sinara-hw/Zotino/DOC/Zotino_mod.png

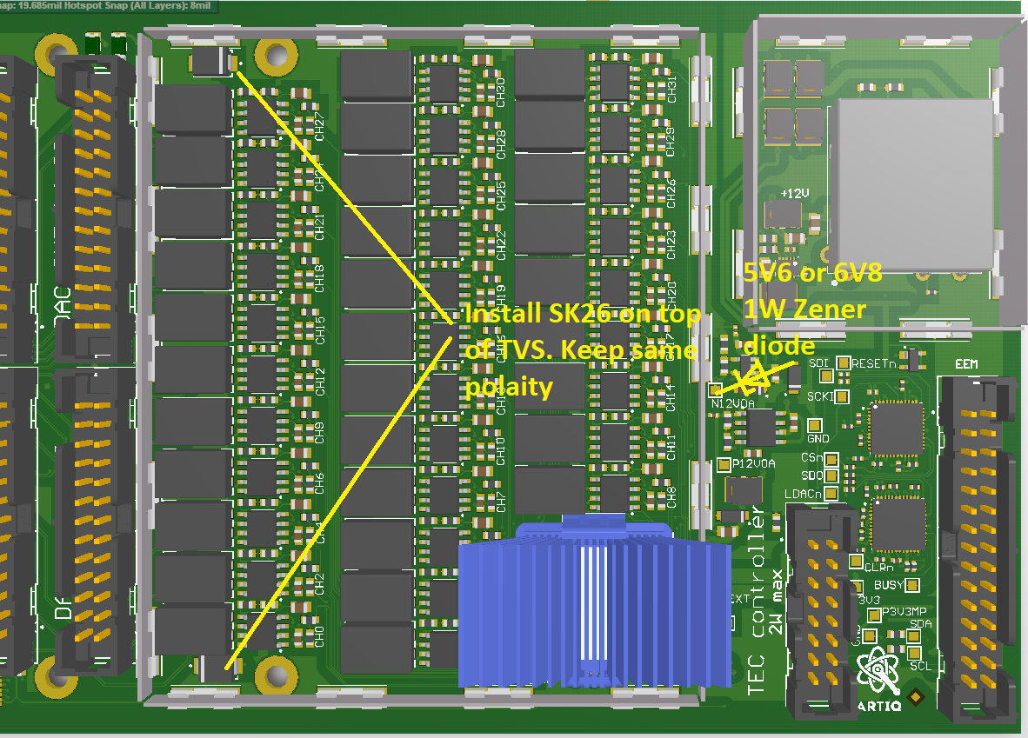
DOC/Zotino_mod.png
