sinara-hw/Zotino/README.md

# Zotino 32-Channel DAC

The Zotino is an ARTIQ-compatible 32-channel DAC. It is in the EEM (Eurocard Extension Module) form factor.

## Design Files

Design files (schematics, PCB layouts, BOMs) can be found at [Zotino/Releases](https://github.com/sinara-hw/Zotino/releases).

This project is mostly edited offline, out of source control, and updated on each release.

## Wiki

More information can be found on the [wiki](https://github.com/sinara-hw/Zotino/wiki).
