sinara-hw/Zotino/SIM/ac response.png

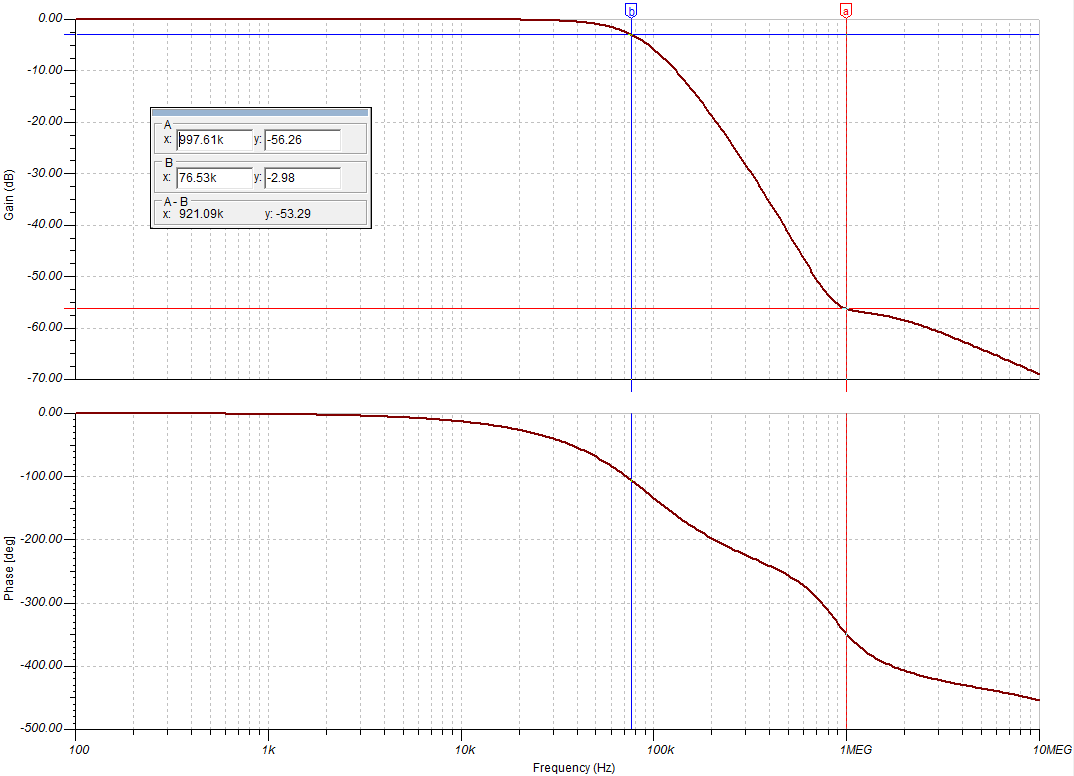
SIM/ac response.png
