sinara-hw/Zotino/SIM/noise spectral density.png

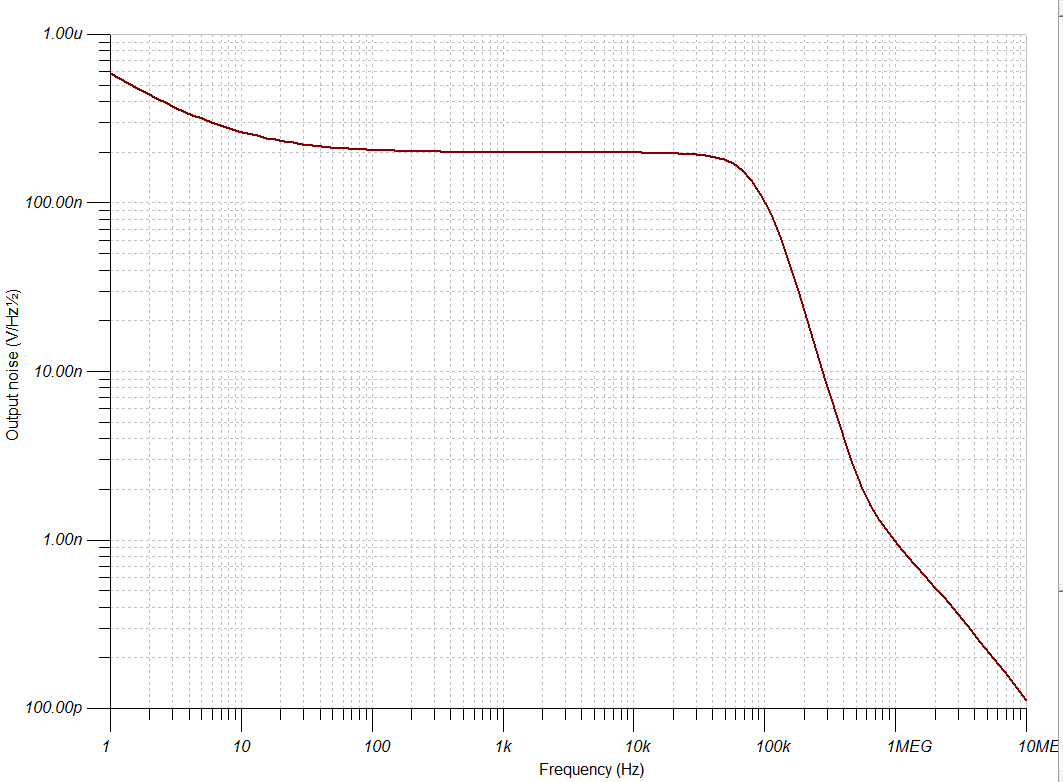
SIM/noise spectral density.png
