sinara-hw/Zotino/SIM/setting time.png

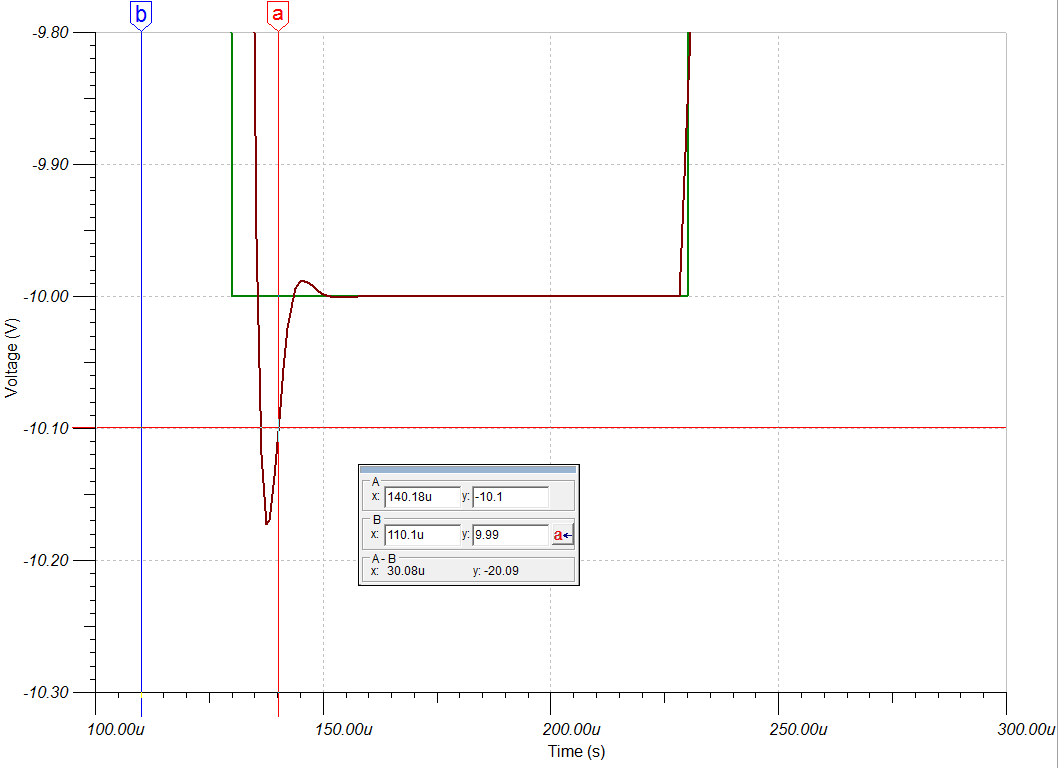
SIM/setting time.png
