sinara-hw/Zotino/(threads)

Thread 1 (2018-04-18):

v1.1 testing

hartytp, 2018-04-18:
- Continued from https://github.com/sinara-hw/sinara/issues/534

- [x] Step response/rise time: switch from -10V to +10V and look at output on scope
- [ ] Noise spectrum with & without constant DAC updates. Look at +-FS and 0V
- [ ] Cross-talk
- [ ] Noise with TEC running
- [ ] Stability with + without TEC connected
- [ ] Small + large signal BW
- [x] DC accuracy as a function of duty cycle (self-heating). Ticked off as this is actually quite tricky to measure and I don't expect it to be a large effect at all. Feel free to untick if you really want to see this measured and are willing to take the data!

hartytp, 2018-04-18:
Note to self, measured temp co looks surprisingly good given the DAC's specifications. However, it was only measured at a single voltage, so it's possible that the results are very different at other voltages. Needs more measurements before we make a final decision about whether to include the TECs as a default population option going forward.

Closed 2019-09-06.

Thread 2 (2018-05-21):

DAC death

sbourdeauducq, 2018-05-21:
Every ~15s my Zotino stops producing an output signal for a few seconds, and the blank period is followed by a burst of noise:
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
This is with a kernel that produces a 1kHz tone:
```python
import struct

from artiq.experiment import *
from artiq.coredevice.ad53xx import *

class Tone(EnvExperiment):
    def build(self):
        self.setattr_device("core")
        self.setattr_device("zotino0")

    @kernel
    def run(self):
        self.core.reset()
        self.zotino0.init()
        delay(1*ms)
        while True:
            self.zotino0.write_dac(1, 0.1)
            self.zotino0.load()
            delay(0.5*ms)
            self.zotino0.write_dac(1, -0.1)
            self.zotino0.load()
            delay(0.5*ms)
```

Even with nothing running on the core device, the bursts of noise are still observed, which points to a  hardware problem:
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

sbourdeauducq, 2018-05-21:
This behavior is observed on at least 2 channels. I don't have another board to test.

gkasprow, 2018-05-21:
Before I manage to recreate the issue, could you please have a look at the supply rails?
+/-12V which supplies DAC and buffers.

sbourdeauducq, 2018-05-21:
Where do I measure those? The PDF schematics aren't in https://github.com/sinara-hw/Zotino

sbourdeauducq, 2018-05-21:
Yep, the power supply is crapping out, here is the -12V:
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

gkasprow, 2018-05-21:
schematics are in [releases ](https://github.com/sinara-hw/Zotino/releases)
OK, so it seems to be the power supply issue. Please check if the power is problematic before the regulators.
What is the output load ?

sbourdeauducq, 2018-05-21:
> What is the output load ?

Open, I only have the scope (1M) connected.

gkasprow, 2018-05-21:
please measure V+ and V- with the scope
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

gkasprow, 2018-05-21:
please also check if the DAC od the LDO above N12V0A is getting hot.

sbourdeauducq, 2018-05-23:
The +12V is working correctly.
The -12V at the output of the LDO has the problem shown above, but its input is stable. It does get very hot. So I guess we are seeing the LDO thermal shutdown.

sbourdeauducq, 2018-05-23:
There is +/-15V at the inputs of the LDOs. Isn't that a bit high?
Also, the -12V glitches only begins to occur after the board has been running for a few minutes, which is consistent with thermal shutdown.

sbourdeauducq, 2018-05-23:
From a cursory inspection (no thermal camera here yet), nothing else on the board other than the DAC chip gets hot. I wonder if it may be drawing more than its specified current.

sbourdeauducq, 2018-05-23:
Contrary to what I thought, the DAC chip on my Zotino 1.1 is not burned, so I have added a heatsink to it and I am testing that board now. The switching regulator output is still +/-15V.

sbourdeauducq, 2018-05-23:
That 1.1 board doesn't have the problem. The -12V LDO is colder, too.

gkasprow, 2018-05-23:
we recreated same problem in the lab. the Zotino board was placed on the most right side of the crate where cooling is not sufficient.

sbourdeauducq, 2018-05-23:
The problem is systematically happening on the v1.2 board, when it is is exposed to air at ambient temperature without hot objects nearby. What should I do, turn on the TEC cooler?

sbourdeauducq, 2018-05-23:
Even with the board outside the crate, the bug is present.

gkasprow, 2018-05-23:
you can try to remove the Peltier module and attach the heatsink directly.

hartytp, 2018-05-23:
@gkasprow you think this is thermal runaway in the dac? That doesn't seem likely to me. On our boards, with no forced air, the dac is barely warm to touch. How hot is it on your board before this issue occurs?

gkasprow, 2018-05-23:
This happens when the DAC even for short moment gets its temperature exceeded. It gets damaged, it still works but consumes much more current so it enters this thermal trip quickly.
Let's add thermal protection in next revision of Zotino which will switch off the power when temperature is i.e. 55 degrees and indicate it with LED.

hartytp, 2018-05-23:
@gkasprow did you test that by heating the dac with a hot air gun?

I just don't get this:
- iirc the dac is rated to normal operation at 85C die temp, and max tem 120C
- the datasheet has curves for current draw versus temperature which show no runaway
- the power consumption is low so the die should only be a few C hotter than the case (based on specifies thermal impedance)
- so unless the dac case / pcb is quite a bit hotter than 85C there should be no problem at all. On my board it just wasnt that hot. So why are we seeing this?
- I've used these DACs on eval boards in enclosures stabilised by resistive heating with no problems. Based on your explanation this should not be possible

So I think there must be some other cause for all of this. What do you think?

sbourdeauducq, 2018-05-23:
> Let's add thermal protection in next revision of Zotino which will switch off the power when temperature is i.e. 55 degrees and indicate it with LED.

If that's really the problem, this won't be a solution: the thermal protection will just be activated all of the time in the field. Again, the bug is present on my board *outside* the chassis, and it's not the hot HK weather, I had AC in the lab.

hartytp, 2018-05-23:
Note to self, let's also check that this isn't something dumb like we've used some DAC variant that's only specified over a very narrow temperature range.

gkasprow, 2018-05-23:
I also have AC in my lab and the failure happened today.
The SMPS delivers max +/- 15V so even if the LDO gets unstable, it is still within safe operation area.
I have the DAC devkit so will give it a try.

gkasprow, 2018-05-23:
I attached the heat sink directly to the DAC after removing the Peltier, the current consumption is stable and the DAC is cold. The board is on the bench and I have the air flow generated by 12V fan supplied from 10V.

gkasprow, 2018-05-23:
I removed the fan and the current consumption started growing. When it had grown by 20mA, I turned the fans on and it felt back to the original value.

jordens, 2018-05-23:
It might generally be wise to enable thermal shutdown in the AD5372 by default in ARTIQ.

hartytp, 2018-05-23:
> I removed the fan and the current consumption started growing. When it had grown by 20mA, I turned the fans on and it felt back to the original value.

Do you know from which rail the current was drawn?

hartytp, 2018-05-23:
Were your observations consistent with the data sheet?

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

hartytp, 2018-05-23:
> It might generally be wise to enable thermal shutdown in the AD5372 by default in ARTIQ.

We did consider that in the past (and it might not be a bad idea to do implement it), but the thermal shut-down only kicks in at 130C die temperature. IIRC, @gkasprow felt that by that point the DAC had been destroyed. Also, it's not great protection, as it doesn't help if the user powers the board on for a while before programming. Better to ensure that Zotino doesn't spontaneously die under normal use.

gkasprow, 2018-05-23:
I took the ADI devkit, powered it on and heated to 97 degrees. Did not observe any change in current consumption. -12V and +12V was below 10mA (bench PSU current display resolution)

hartytp, 2018-05-23:
Good!

So, either the DAC on Zotino has been damaged by something, which is leading to this behaviour. Or, we have some connection on Zotino that's different to the eval board. The question is which one? Maybe try disconnecting all the OpAmps from the DAC outputs?

gkasprow, 2018-05-23:
My DAC on Zotino is already broken. What I can do is to measure the output current on the RC filter resistors.
I will also check how the +/- 12V rails wake up.

jordens, 2018-05-23:
I am pretty sure that the thermal shutdown is designed to prevent and identify (since it doesn't clear itself) destructive temperature excursions. And I'd bet that if the damage is thermal, the shutdown would trip. But yes, I'd also bet that the problem is not bad cooling.

gkasprow, 2018-05-23:
the +/- 12V rails wake up in monotonic way. +12 wakes up faster than -12V.

hartytp, 2018-05-23:
> I am pretty sure that the thermal shutdown is designed to prevent and identify (since it doesn't clear itself) destructive temperature excursions. And I'd bet that if the damage is thermal, the shutdown would trip. But yes, I'd also bet that the problem is not bad cooling.

Exactly.

gkasprow, 2018-05-23:
I let the DAC to trip. Then I switched on the fan and the current consumption got lowered to initial value...
So it does not seem to be any latchup effect.

gkasprow, 2018-05-23:
There is one difference between eval kit and Zotino.
On Eval kit the pin 13 is grounded.
In datasheet is is marked as NC

gkasprow, 2018-05-23:
I connected it to GND but it did not help

gkasprow, 2018-05-23:
the DAC accepts up to 5V on digital supply. We have 3.3V supply which also supplies the LVDS drivers. And these drivers would be killed first.

gkasprow, 2018-05-23:
I'm just curious if this un-connected NC pin could kill the DAC. The reference can survive up to 40V on its input.
The DAC draws excessive current from its negative rail.

hartytp, 2018-05-23:
Sure, my point is just that characterizing the dead DAC carefully may not tell you anything about what killed it.

gkasprow, 2018-05-23:
I have one more Zotino that works correctly. I shorted pin 13 to GND and that's the only think I can do.
I can heat it to 90 degrees and see how it behaves.

gkasprow, 2018-05-23:
I have one more Zotino that works correctly. I shorted pin 13 to GND and that's the only think I can do.
I can heat it to 90 degrees and see how it behaves.

gkasprow, 2018-05-23:
I posted it here
https://ez.analog.com/message/350275-failing-ad5372-dacs

dhslichter, 2018-05-23:
Looks like AD suggests powering up as -12V, +12V, +3.3V:

https://ez.analog.com/thread/47483

gkasprow, 2018-05-23:
I've noticed that. It is recommended pattern. We should fix it in next revision just in case.
I applied other sequences to the devkit and nothing happened.

hartytp, 2018-05-23:
@dhslichter I've seen that post before, but I don't think it applies to us. Importantly, Zotino should meet all the absolute maximum ratings by design. e.g. the digital sequencing shouldn't matter, since the inputs/outputs connect to ICs that run from the same regulator as Zotino.

Also, I've run eval boards for this DAC from bench top PSUs with no real care paid to power sequencing and never seen an issue like this.

hartytp, 2018-05-23:
> The reference can survive up to 40V on its input.

The data sheet says 5.5V max for VREF0 and VREF1

hartytp, 2018-05-23:
hmm I really can't think of anything to do here apart from removing all components from a working board until we strip it down to the very most basic design. If that works, then add things one by one and try to see which causes DAC death.

gkasprow, 2018-05-23:
Another observation - the board with issues, has them from very beginning. There are boards that work perfectly fine.
I tried with temperature and various supply sequences on devkit and they didn't harm it.
I will try the same with the board that works fine. But it's quite possible that we never find the problem in this way.
I'll do yet another thing - buy a few DACs and will work on the same board that causes issues.
I will replace the DAC on particular board and will see if the issue reappears.
If not, I will play with voltage sequencing and logic levels during power up...

gkasprow, 2018-05-23:
@hartytp I mean 40V for reference IC.

dhslichter, 2018-05-23:
> Also, I've run eval boards for this DAC from bench top PSUs with no real care paid to power sequencing and never seen an issue like this.

Same here, I merely mentioned it in case it might make a difference.

sbourdeauducq, 2018-05-25:
Cooling the DAC chip works around the problem.

klickverbot, 2018-05-31:
For the record, one of our boards (v1.2) has developed this issue now as well (N12V0A dropping to ~2.5V every few seconds).

gkasprow, 2018-05-31:
I've ordered a bunch of DAC chips and will play with them to identify a moment where the DAC starts consuming excessive power on negative rail. Did not manage to do it with devkit.

cjbe, 2018-06-01:
To add to @klickverbot's comment, the v1.2 board we saw this problem on was new, and showed the problem within a few hours of powering it on for the first time (i.e. we powered it on, and saw the problem as soon as we looked for it).

There has been a v1.1 Zotino sitting in the same airflow within 10cm of the problematic v1.2 - this v1.1 Zotino has been working for a month with no issues.

jordens, 2018-06-01:
I enabled OT shutdown by default. This should at least keep the chips from dying in many cases. https://github.com/m-labs/artiq/commit/2c344686d9b0f8c3f8cc65db692468e7ac443310

sbourdeauducq, 2018-06-02:
Here is a picture of the DAC on the faulty board, in case this is an issue with a certain batch of chips.
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

hartytp, 2018-06-14:
@gkasprow any luck tracking this down. I'm going to buy a few of the DAC chips and have a look at the dead board here.

hartytp, 2018-06-14:
@gkasprow did you see that you got a follow up question from ADI? https://ez.analog.com/message/350275-failing-ad5372-dacs

hartytp, 2018-06-14:
@gkasprow Having said that, I don't see the BCPZ package stocked in any of the usual places on less than a 6 week lead time! Am I missing something?

jordens, 2018-06-14:
That might be a production issue. Digikey says that delivery is past due.

hartytp, 2018-06-14:
Yes, and the power detectors for booster are on 1 month lead time as well...

gkasprow, 2018-06-14:
Lead time is serious problem that touches the industry. The economy in
China boosted so much that they consume all resources. Look at the prices
of 100nF capacitors - they increased over 300% last year. It's extremely
hard to get i.e. 10uF X7R 0805 capacitors.

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

hartytp, 2018-06-14:
Ouch!

Out of curiosity, did you order any more DACs to help debug this issue? If not, does that mean that we can't do any work to try to fix Zotino for another 6 weeks?

gkasprow, 2018-06-14:
I did, tomorrow I will take them from Technosystem. Ordering things at the
WUT is real nightmare.

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

hartytp, 2018-06-15:
:+1:

dhslichter, 2018-06-15:
Or buy from Verical [here](https://www.verical.com/pd/analog-devices-data-acquisition---dac-AD5372BCPZ-1029554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), or directly from Analog Devices [here](http://www.analog.com/en/products/digital-to-analog-converters/standard-dac/precision-dac/bipolar-da-converters/ad5372.html).  For reference, [Octopart](https://www.octopart.com/) is a pretty awesome tool for figuring out who has what in stock....

gkasprow, 2018-06-15:
It's not a problem with buying things but letting WUT bureaucracy to pay for them. It takes months. Doing via private company is simpler :)

hartytp, 2018-06-18:
> directly from Analog Devices here

Only if you want to buy a tray of 260 DACs.

> Or buy from Verical here,

even there, it's a MOQ of 8 and two weeks before shipping. Plus the fees/paperwork involved with shipping from the US.

I was just surprised that none of the usual suspects stock this atm, but I suspect it's because we're using the obsolete package.

hartytp, 2018-07-03:
Switched the DAC for a new one, but the N12V0 is still at 0.7V.

Maybe the negative regulator is struggling to startup with the heavy load presented by all the OpAmp biases. I'll add an RC delay on the P12V0 and see if that helps...

hartytp, 2018-07-03:
@gkasprow Two observations, which might help to explain all this:
1. The negative regulator is 200mA, while the positive regulator is 500mA. So, it should be expected that the positive rail will always switch on faster than the negative rail
2. The negative regulator goes high-Z when its output is reverse biased.

Given the relatively high forwards voltage of the Zener diodes installed on Zotino by default, it should thus be expected that the negative regulators will often go into lock up

gkasprow, 2018-07-03:
did you add the schottky diode?

hartytp, 2018-07-03:
Yes, but the one I added seems to have died...

gkasprow, 2018-07-03:
I'm testing the board I have and power sequencing looks OK
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

klickverbot, 2018-07-03:
Hmm… The 1PS79SB30 can supposedly take 300 mA peak forward current – if it died from that, where is this much current even being sourced from safely?

gkasprow, 2018-07-03:
another scale
![Uploading tek00129.png…]()

gkasprow, 2018-07-03:
It could happen that Zotino starts with some load connected. Then the current drawn from negative source could be much higher causing the LDO startup to fail and triggering the latchup in DAC.

hartytp, 2018-07-03:
> are U sure there is -13V present ?

Yes, the +-13V rails start up nicely.

> It could happen that Zotino starts with some load connected. Then the current drawn from negative source could be much higher causing the LDO startup to fail and triggering the latchup in DAC.

Yes, but right now I'm not even seeing a hundred mV negative at startup, which is surprising...

gkasprow, 2018-07-03:
Maybe the negative DAC supply is shorted with some output?

hartytp, 2018-07-03:
> Maybe the negative DAC supply is shorted with some output?

What would that explain? My observation is that when the N13V0 supply comes on, the N12V0 does not produce any voltage (even -20mV or so). After 20ms or so, the P12V0 regulator switches on and the N12V0 rail goes to +0.7V (the Zener diode forward conductance). That suggests that the N12V0 regulator is dead. But, it should be very hard to kill this regulator, so I have no idea what happened...

gkasprow, 2018-07-03:
this would explain too high current drown by negative DAC rail. Is the LDO getting hot?

hartytp, 2018-07-03:
After disconnecting the positive LDO shutdown pin, the negative rail now comes on to -0.5V. +12V supply current draw is 100mA.

hartytp, 2018-07-03:
What's odd is that the LDO output starts up very slowly (maybe 10s to reach -0.5V). But, the +12V supply current goes immediately to 100mA (even when the LDO output voltage is very low). The -12V rail discharges equally slowly, suggesting that it's not just shorted.

hartytp, 2018-07-03:
> Is the LDO getting hot?

Not noticeably

gkasprow, 2018-07-03:
When I was playing with Sayma, i noticed that negative LDO can disable itself when started with positive voltage. But Schottky diode managed to prevent such case.
You can send it to me for further examination.

marmeladapk, 2018-07-03:
@gkasprow We have one Zotino which overheats, mounted leftmost in our 3U crate.

gkasprow, 2018-07-03:
I'm just using it.

hartytp, 2018-07-03:
@gkasprow The 100mA current draw I see on the 12V rail when the positive LDO is shutdown is consistent with the expected current draw from the LVDS interface. So, it seems that on this board the negative LDO is just dead.

Let me post this Zotino back to you for further examination. The symptoms it displays (no -12V supply) are different to all the other Zotinos we've looked at so far, which all have high current draw on the negative rail, so it's probably a different issue entirely.

hartytp, 2018-07-03:
@gkasprow let's confirm once and for all that we understand what's going on here. How about this:
- take a working Zotino, which does not display this issue. Maybe try taking the damaged one and replace the DAC and check that it behaves normally, according to the data sheet
- replace the Zener diodes with Schottky diodes such as SS14
- use a VHDCI carrier card to connect Zotino to a remote programmable 12V supply
- connect the -12V supply to a digitally readable voltmeter
- do not fan cool it, so that any issues with the DAC are easy to spot (fan cooling should not be necessary to avoid damage)
- now run the following measurement 1000 times or so:
  - power Zotino on
  - wait a second or so for everything to start up
  - measure the negative supply rail a few times over 1 second to look for issues
  - power the board down
  - wait a few seconds
- if that works then replace the Schottky diodes with the Zener diodes and repeat the measurement

Hopefully, we will see that nothing breaks with the Schottky diodes, but it dies quickly with the Zener diodes. In that case, we know that we can resolve it by swapping the diodes on all boards as well as any dead DACs.

How does that sound? Can you do that measurement at some point in the next few days, please?

gkasprow, 2018-07-03:
@hartytp Yes, I will.

hartytp, 2018-07-03:
Amazing, thanks Greg.

gkasprow, 2018-07-04:
I got 3 Zotinos, but they were already tested. I hope the DAC survived. I will have tomorrow a few spare DAC chips. I can do tests next week.

gkasprow, 2018-07-05:
@hartytp I got your ZOtino.
The DAC chip seem to be alive, it consumes current close to zero.
But I've noticed that the AFE part consumes quite high current when the voltage is rising.
When positive voltage is lower than 2.1V, the negative consumes nearly 100mA. When it is higher, it drops to 40mA (AFE current).
The negative current drops suddenly once negative voltage exceeds 3.0V
So this would explain very fragile nature of power sequencing. Any imbalance causes that either negative wakes up later or not at all.

hartytp, 2018-07-05:
@gkasprow good catch! That explains a lot.

So, the best solution is probably to add power sequencing for the next version to turn the negative rail on first.

To fix this version, shall we add an RC delay to the positive regulator enable as well as the Schottky diodes?

gkasprow, 2018-07-05:
With SK26 diode, the negative voltage goes to -0.33V for a while.

gkasprow, 2018-07-05:
I wouldn't leave it as it is.

gkasprow, 2018-07-05:
I compared 4 diodes at 150mA:
S5189 : 0.31
SK26 : 0.31
SS18: 0.47
SS34: 0.33V

hartytp, 2018-07-05:
> I wouldn't leave it as it is.

I'm not sure I follow you here. Do you mean "I wouldn't change anything; leave it as it is." Or do you mean "I wouldn't leave it as it is; we must change something."?

gkasprow, 2018-07-05:
I meant that I'm not sure if we can leave these +0.33V on negative rail.

hartytp, 2018-07-05:
Yes, I think we should add some proper power sequencing to turn the negative rail on first and off last.

For the time being, an RC delay on the positive regulator should fix it, right?

gkasprow, 2018-07-05:
Let me check it first :)

gkasprow, 2018-07-05:
the negative LDO is simply dead. it does not consume any current

gkasprow, 2018-07-05:
I installed new one and it is still dead :D

hartytp, 2018-07-05:
Bad solder joint somewhere?

gkasprow, 2018-07-05:
nope, I soldered LT1964ES5-SD#TRPBF instead which has shutdown pin instead of BYP pin ...

gkasprow, 2018-07-05:
And I cannot find which one was installed originally in your board

hartytp, 2018-07-05:
@gkasprow I'm pretty sure I checked the package markings and the one that was originally on my board was the BYP model.

gkasprow, 2018-07-05:
I'm surprised that in rev1.0 there was used LTVX version (with shutdown) instead.. And I simply moved the chip to v1.2 :)

gkasprow, 2018-07-05:
after I replaced the LDO and added SK26 diode, your board seem to work.

hartytp, 2018-07-05:
> after I replaced the LDO and added SK26 diode, your board seem to work.

Glad to hear it!

If you hold the positive regulator in shutdown then what is the supply current? Do you think it would make sense to add power sequencing that holds the positive rail in reset until the negative rail has come on?

gkasprow, 2018-07-05:
@hartytp there are two things that need to be fixed in next revision:
- usage of higher current  negative LDO. It's quite possible that on some boards 200mA of LDO may be not sufficient to deliver inrush current for AFE
- Schottky diodes. SS14 is not sufficient, it needs to be SK24 or another with low voltage.
- Optionally power sequencing for positive voltage to make sure it wakes up slightly later. But with protection diodes and stronger LDO I'm not sure if this is really necessary.

hartytp, 2018-07-06:
@gkasprow hmm...combining a shcottly diode in shunt to ground at both LDO outputs, with a 3V Zener between the negative regulator input and output might be the best approach here. It's also easy to patch existing boards.

hartytp, 2018-07-06:
Anyway, @gkasprow please can you pick which solution you think is best (higher current negative LDO v Zener diode) and suggest which components we should use. We should then order the components and verify that the boards work.

I'd really like to close this issue soon so that we can finish Zotino!

gkasprow, 2018-07-06:
We can simply use 2 LDOs, one for AFE and one for DAC.
Zener diode is also OK

hartytp, 2018-07-06:
> We can simply use 2 LDOs, one for AFE and one for DAC.

We had that in v1.0 and the DACs still died. Maybe with the Schottky it's okay.

> Zener diode is also OK

Well, which solution do you prefer? Please can you pick one and suggest which changes we need to make to the board for the next revision (including part numbers of any new components).

gkasprow, 2018-07-06:
dual negative LDO can cause another issues with AFE/DAC power sequencing. I will simply use LDO with higher current. Zener diode does not provide any current limit and when overloaded it simply shorts pins.
6V Zener + Schottky can be added for current batch of boards

hartytp, 2018-07-06:
>  Zener diode does not provide any current limit and when overloaded it simply shorts pins.

True. The datasheet SMPS we're using doesn't say much about the protection it has. Can it withstand an indefinite short between the + and - outputs? If not then the Zener could be dangerous.

> I will simply use LDO with higher current.

Which LDO do you want to use? Maybe we can dead bug it onto the current boards?

gkasprow, 2018-07-06:
There are not many to choose, maybe [this one](http://www.analog.com/media/en/technical-documentation/data-sheets/1175ff.pdf)

hartytp, 2018-07-06:
> There are not many to choose,

[TI](http://www.ti.com/power-management/linear-regulators-ldo/single-channel-ldo/products.html#p451max=0.5;7.5&p634min=-37;-12&p634max=-12;125) has a decent selection (better than ADI/LTC).

ON also have some nice ones.

>  maybe this one

LT1175 is fine but kind of expensive and not so widely stocked.

What about: MC79M12? Cheap, low noise compact and generally nice. Not stable with ceramic capacitors.

hartytp, 2018-07-06:
@gkasprow please can you ensure that we check all other designs for related issues (#6 and #8).

In particular, what about Sampler, which has quite a few of these problematic OpAmps...

hartytp, 2018-07-06:
@gkasprow unless you object to SK24 MC79M12 I'll order the parts and do some tests on one of our boards to ensure that it can withstand 1k power cycles without damage. If it can then I'll close this issue.

gkasprow, 2018-07-06:
I was looking for sth that can be easily soldered.
In case of TI there are just 2, but have 1A current: TPS7A33, LM2991
Good old MC79M12 or LM337 need over 1V of dropout and are not that good with noise as the one we use.

gkasprow, 2018-07-06:
SK26 + MC79M12 would be fine as quick fix

hartytp, 2018-07-06:
@gkasprow the noise for the MC79M12 is pretty decent (40uV is not bad for a -12V regulator) although, I don't think that low-frequency LDO noise is likely to limit us in this design...But, you're right, the drop out is a little high.

hartytp, 2018-07-06:
@gkasprow hmmm what's the point of having a 1A LDO when the [SMPS](https://us.tdk-lambda.com/ftp/Specs/cc-e.pdf) is only rated to 250mA?

hartytp, 2018-07-06:
Anyway, @gkasprow let's make a decision about this so we can test it and move on...

gkasprow, 2018-07-06:
The SMPS has current limit on input power, not output current.
So you can load it for a moment with 500mA or more on negative rail.
 I'm little worried about load of the MC79M12 - we ave 32x 100nF ceramic capacitors that may make it unstable. From my experience with similar chips I know it does not like more than 1uF ceramic at its output.
But since
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

Thread 3 (2018-05-22):

v1.2 incomplete IDC connector soldering

jordens, 2018-05-22:
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

hartytp, 2018-08-15:
can we close this? What needs to be done?

jordens, 2018-08-15:
The fabrication process should be checked and debugged so that these things don't happen.

hartytp, 2018-08-15:
Okay. I think it's probably best to move this over to the `meta` project, since it is likely to effect all EEM designs.

Closed 2018-08-15.

Thread 4 (2018-05-25):

v1.2 heatsink glue softens when warm

sbourdeauducq, 2018-05-25:
I turned on the TEC and when the heatsink became hot (~45C), the glue became very soft and did not hold the heatsink properly anymore.

gkasprow, 2018-07-06:
OK, so we will install mechanic holder as it was originally foreseen.

hartytp, 2018-07-06:
We should do the same for Kasli, which can also get quite hot without a proper fan...

Closed 2018-08-14.

Thread 5 (2018-06-18):

Switch DAC package

hartytp, 2018-06-18:
Looks like the AD5372BCPZ (LFCSP package) is being discontinued http://www.analog.com/media/en/PCN/ADI_PDN_16_0050_Rev_B_Form.pdf p47.

Replacement is the AD5372BSTZ (LQFP). Let's switch to that for the next revision as the availability seems to be better (although, the thermal impedance is marginally higher).

dhslichter, 2018-06-18:
Sounds good to me.

gkasprow, 2018-08-13:
well, they say that "PDN is no longer applicable for this part.It has been removed on this version of the PDN"
It's available now.

hartytp, 2018-08-14:
@gkasprow okay, if it's no longer depreciated then we can keep the current package. However, I still had the impression that the package we are using is harder to get hold of (fewer people seem to stock it), so we might want to change anyway. I'll leave that to you.

gkasprow, 2018-08-14:
I managed to place both footprints so any package can be installed.

gkasprow, 2018-08-14:
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

hartytp, 2018-08-15:
:) that solves that problem

Closed 2018-08-14.

Thread 6 (2018-06-27):

LDO reverse voltage diode

hartytp, 2018-06-27:
@gkasprow On one of my boards, I measure +0.7V on the N12V0 rail.

Looking again at the schematic, it seems that D11 and D12, which are supposed to prevent the LDOs from being reverse biased during turn on/off are Zener diodes. However, the DAC data sheet specifies an absolute maximum voltage on the N12V0 rail of +0.3V, so we're exceeding this and could easily destroy the DAC like that.

- [ ] D11 and D12 should be Schottky diodes. In the past, I've found it necessary to select diodes with very low turn on voltages to ensure that the diodes switch on before the protection diodes in the DAC (e.g. by +0.4V the DAC could be passing quite a lot of current through its internal diode junctions). Might also be worth adding a small resistor on the supply rails to help ensure that the external protection diode switches on hard before the internal ones do....

I have a feeling that this explains our mysterious DAC deaths, but I can't test that until the DAC goes back into stock somewhere...

**Let's use SK24**

hartytp, 2018-06-27:
NB all other Sinara boards should be checked for this issue.

klickverbot, 2018-06-27:
You mean D10 and D11 in v1.2rc1, right? Good catch – we should probably be using something like the [DB2S20500L](https://industrial.panasonic.com/content/data/SC/ds/ds4/DB2S20500L_E.pdf) (obviously part choice depends on how much current can be sourced).

hartytp, 2018-06-27:
@klickverbot right. Those look pretty good, but really anything chosen for low forwards voltage at a hundred mA or so. Ideally, we'd want something that can take the entire output of the LDO, so either parallel a few diodes, or find one with a low forward voltage and a higher max current.

hartytp, 2018-06-27:
@klickverbot do you have any of those in stock that I can nab?

gkasprow, 2018-06-27:
@hartytp This makes sense. In our case the part that may cause damage is AFE which consumes power between V+ and V- unlike the DAC itself. And the AFE current can bias the DAC in wrong way when one of rails wakes up a bit earlier.
That's why I did not manage to kill the devkit because there was no AFE that draws the current.
Any schottky diode with low Vf would work, even SS16 - they have similar characteristics as one posted above. The AFE-generated current can simply trigger latchup mechanism and negative supply current does damage.

The only fact that does not fit to this theory is that the prototype had independent regulators. But since the LDOs are mainly based on MOSFETs, they heve reverse diodes which managed to close the loop from the AFE rail to the DAC rail.

hartytp, 2018-07-03:
@klickverbot I ordered some SS14, which seem like a good choice for this.

gkasprow, 2018-07-10:
I installed 6V8 Zener diode in parallel with negative LDO on 4 boards + 2x SK26 on top of TVS diodes.
It works, no excessive current is drawn.

gkasprow, 2018-07-18:
Fully agree.

Closed 2018-08-14.

Thread 7 (2018-07-03):

Zotino rev1.1 issue

prasath-d, 2018-07-03:
Hello,
I am using zotino rev1.1 with kasli as a controller.
I tried to set the voltages in the DAC channel by using the code given in the demo program.
```
import numpy as np
from artiq.experiment import *

class zotino_demo(EnvExperiment):
    def build(self):
        self.setattr_device("core")
        self.setattr_device("zotino0")

    @kernel
    def run(self):
        self.core.reset()
        self.zotino0.init()
        delay(100*ms)
        while True:
            self.zotino0.set_leds(0xff)
            delay(100*ms)
            self.zotino0.set_dac(
                [-9. + i*.5 for i in range(32)],
                list(range(32))
            )

```
The output I got from one of the channel was
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
There is a deadtime of 2s between every 600ms.
Then tried to understand the problem by modifying the code.
```
import numpy as np
from artiq.experiment import *

class zotino_demo2(EnvExperiment):
    def build(self):
        self.setattr_device("core")
        self.setattr_device("zotino0")

    @kernel
    def run(self):
        self.core.reset()
        delay(100*ms)
        self.zotino0.init()
        while True:
            self.zotino0.set_leds(0xff)
            delay(10*ms)
            self.zotino0.set_dac(
                [-9. + i*.5 for i in range(32)],
                list(range(32))
            )
            delay(10*ms)
            self.zotino0.set_dac(
                [9. - i*.5 for i in range(32)],
                list(range(32))
            )
            delay(10*ms)

```
This switches the output voltage every 10ms from positive to negative and, I saw the same
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
The output works for 600ms and stops working for 2s.

I recorded the output, when no program is running.
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
where, there is a noise output of around ~10mv which is also having 600ms width and 2s of deadtime.
could you please help me in understanding this issue. is it a hardware issue or I am missing something?
Thank you

hartytp, 2018-07-03:
https://github.com/sinara-hw/Zotino/issues/2 :(

jbqubit, 2018-07-10:
cf https://github.com/sinara-hw/Zotino/issues/2#issuecomment-403926712

Closed 2018-07-03.

Thread 8 (2018-07-06):

jack screws

hartytp, 2018-07-06:
We tend to use screw in HD68 cables rather than the clip in ones. Unless anyone objects, can we add the jack screws for the HD68 connector to the BOM and have them populated by default?

jordens, 2018-07-06:
Yes. And open up the panel to give access to the threads (Zotino, HD68IDC, Grabber). I think I filed an issue about that but can't find it right now.

gkasprow, 2018-08-14:
added 2x 786585-2

hartytp, 2018-08-14:
@gkasprow thanks! Did you change the panel cut out as well?

gkasprow, 2018-08-14:
yes

Closed 2018-08-14.

Thread 9 (2018-07-06):

Replace negative LDO

hartytp, 2018-07-06:
Needs a higher output current to ensure proper startup of AFE OpAmps.
- Let's use MC79M12

Thread 10 (2018-07-10):

SMPS voltage incorrect

hartytp, 2018-07-10:
@gkasprow the SMPS should be putting out +-13V. It seems to put out +-15V. The same happens on Sampler v2.0. Can you reproduce this on your board?

gkasprow, 2018-07-10:
I've noticed that recently.
The datasheet specifies it as:
Ra = 53.55 / (Vout - 12.02) - 18
We want +/- 13V so Ra = 36R and such resistor is installed.
I will play with this resistor.
AFAIR in previous series I measured +/- 13V....

hartytp, 2018-07-10:
> I've noticed that recently.

Okay, glad you see this too so it's not just me!

> We want +/- 13V so Ra = 36R and such resistor is installed.
> I will play with this resistor.

Yes, AFAICT the datasheet is correct. So, it's not clear to me why we're getting the wrong voltage.

hartytp, 2018-07-11:
@gkasprow  ooops :)

the units of the 36 resistance are kOhms, not Ohms. Which, when one thinks about it is kind of obvious; the drive current on that pin is probably only uA, which is pretty hard to measure with a 36Ohm drive resistor.

hartytp, 2018-07-11:
Confirmed on two boards: Ra=36k gives +-13V.

This isn't really a problem as using +-15V only increases the power consumption a bit. So, while we should fix this for the next revision, I don't think it's worth patching existing boards. It does mean that the max current the SMPS can supply will be a bit lower than it would otherwise be...

Closed 2018-08-14.

Thread 11 (2018-07-11):

SMPS output capacitors

hartytp, 2018-07-11:
Documentation for the SMPSs we're using can be found [here](https://docs-apac.rs-online.com/webdocs/0826/0900766b808264e4.pdf)

Note that for the PSU we're using, the maximum allowed output capacitor is 10uF. We're currently using 22uF. In practice, this is probably fine because the DC-bias will reduce the capacitance by a factor of a few. But, it's worth adding a note to the schematic about this, and it's worth double checking that we're happy with the current arrangement.

Closed 2018-08-14.

Thread 13 (2018-07-11):

SMPS over current

hartytp, 2018-07-11:
@gkasprow the SMPS is only rated to withstand over-current conditions for up to 30s. After that it can be damaged. Are we sure that we're okay with that. e.g. this means the SMPS can easily be damaged if the SCSI connector draws too much current.

hartytp, 2018-07-11:
@gkasprow what do you want to do about this?

My worry is a situation like this:
- someone connects the outputs of Zotino to a capacitive load, so the DC load current is 0mA
- someone draws some current from the SCSI connector
- no they start changing the outputs rapidly, so the AC current draw is high. At this point they hit an over current condition

Or, simply the fact that the SCSI +-13V outputs are not properly current limited and shorting them for more than 30s could damage the board.

So, I think we should either use a bigger SMPS (and, maybe one with more robust protection), or do something like:
- do not connect the +-13V to the SCSI/IDCs by default. Instead, add DNF 0R resistors that must be populated to connect the power
- add a clear warning to the power budget/connector page explaining all of this

We should also add a note on the power page that the SMPS cannot withstand an indefinite over current condition.

gkasprow, 2018-07-11:
We can add PTC fuses rated for i.e. 50mA.

gkasprow, 2018-07-11:
Since external AFE is not yet defined I'm not sure if it's worth to provide symmetrical power supply from Zotino. There will always be a case that it is not enough. Over-rating SMPS on Zotino would be costly.
Maybe just leave +12V rail and install dedicated SMPS on remote AFE? Or get rid of any supply..

hartytp, 2018-07-11:
> Maybe just leave +12V rail and install dedicated SMPS on remote AFE? Or get rid of any supply..

I think that one of those two options would be better.

gkasprow, 2018-07-11:
So let's put 0R jumper so when needed, 12V can be used to supply to remote AFE.

Thread 16 (2018-08-14):

heatsink too high

gkasprow, 2018-08-14:
The heat sink collides with neighbouring panel.

gkasprow, 2018-08-14:
I want to replace it with ATS-56001-C3-R0. It has slightly lower thermal resistance but does not have mechanical assembly kit. 9mm vs previous 12.5mm should solve the issue.

hartytp, 2018-08-14:
> but does not have mechanical assembly kit

how will you attach it to the PCB?

gkasprow, 2018-08-14:
we will glue it, but with dual-compound thermal adhesive. Existing heat sinks were glued using dual sided bonding tape with copper core but it melted at higher temperature.

hartytp, 2018-08-14:
Cool. If you think that's the right solution then it's fine by me

Closed 2018-08-14.

Thread 18 (2018-08-15):

v1.3 review

gkasprow, 2018-08-15:
I drafted new [release](https://github.com/sinara-hw/Zotino/releases/tag/Zotino%2Fv1.3)
@hartytp @jordens please have a look.

gkasprow, 2018-08-15:
I've just noticed that version on schematics is 1.2 instead of 1.3

gkasprow, 2018-08-15:
I also published short form schematics, but without assembly variants.
Altium gives two options - original schematics or physical schematics but with assembly variants.

hartytp, 2018-08-15:
Look good, thanks!

That looks really good, thanks again for all your hard work on this! FWIW, I'm considering v1.3 to be the first revision that's "production" rather than "prototype".

- on the schematic, the shield clips aren't labeled DNF. Should they be?
- IIRC, the reason you didn't 0-index the channels on the HD68 and IDCs was some Altium issue. That's totally fine (I'm just adding this note as a reminder to myself)
- were we planning to have TVS as well as Schottky diodes on this design? Or, not bother?

gkasprow, 2018-08-15:
@hartytp as I wrote, look at the right schematics. There are two versions.
TVS were only to protect against feeding power from AFE.
Since we won't supply AFE from Zotino, they are not needed.
0-indexing is Altium feature. We can migitate it by placing 32 copies of the output_channel block on the schematic.

gkasprow, 2018-08-15:
I do not change designators/properties to DNF because during library update they are reverted back to original values. Instead I use either no_value components or assembly variants.

hartytp, 2018-08-15:
thanks for the clarifications Greg.

That all looks good to me!

Closing this issue, but others should feel free to reopen if they spot anything.

jordens, 2018-08-15:
Oh. And since we have now one repo per board, we can call the git tags just "v1.3" without the "Zotino/" prefix.

hartytp, 2018-08-15:
> I consider the v1.1 and v1.2 designs also "production". They just have an error that requires rework.

True. But, they way I look at it, if you apply the rework to those designs then they are effectively v1.3 boards. Anyway, I didn't really mean much by that comment other than that I'm happy the bugs seem to be fixed and it works really nicely

Closed 2018-08-15.

Thread 19 (2019-01-07):

support for CPCIS

gkasprow, 2019-01-07:
add mounting holes and align connectors for CPCI S adapter

gkasprow, 2021-11-05:
fixed in 1.4

Closed 2021-11-05.

Thread 20 (2019-05-16):

Power cycling problem

krmac, 2019-05-16:
I've noticed that some boards have problem with quick power cycling. Here is the example:

1. Power supply is on, board is working correctly, consumes about 190 mA.
2. I switch power supply off.
3. I switch power supply on after e.g. 3 seconds. Now board consumes 90 mA, there is +2V on +Vout and -2V on -Vout instead of +13V and -13V.

Here is the measurement on -Vout (CC6-1212DF-E):

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

To get the board to work again it is needed to switch power supply off, wait for up to 10 seconds until capacitors are discharged and after switching power supply on again board will work correctly.

hartytp, 2019-05-16:
Which hw revs?

krmac, 2019-05-16:
v1.3

gkasprow, 2019-05-16:
It looks like the DC/DC converter module does not like the power transients and needs the output voltage to fall to zero before input can be re-applied.
We can increase the load or add transistor circuit that discharges output capacitors when input power was removed.

hartytp, 2019-05-16:
> or add transistor circuit that discharges output capacitors when input power was removed.

If we decide to do that, we should consider what other designs need this feature as well.

hartytp, 2019-05-16:
Might be worth power cycling one of these supplies a few times with the loads (other than the capacitors) disconnected to check that it really is the TDK supply failing to start with an output voltage already there.

gkasprow, 2019-05-16:
Let's add 1k resistor to the problematic rail and see if that helps.

hartytp, 2019-09-07:
I've done quite a few design reviews for Sinara recently and a decent fraction of the SMPSs/LDOs we use will explicitly not start correctly into pre-biassed loads. Then there are also the issues around getting power sequencing right with pre-biassed loads.

FWIW quite a lot of commercial equipment will also misbehave if the power is cut very briefly IME. I think the amount of extra complexity, design and testing work that would be required to make Sinara hw always start reliably after brief power cuts is not worth the benefit; it's a surprisingly messy thing to make work.

Note that in this specific case, it's not even 100% clear if the issue is really with the main +-12V SMPS not starting correctly, or with some component that follows it misbehaving and then causing the regulator to current limit, so more debugging would be needed to identify the appropriate solution.

In general I'm also against adding bleed resistors, since they're typically either to small to do anything or large enough to waste a significant amount of power. e.g. Zotino already has quite a bit of quiescent current draw from these rails, so I don't think a resistor will do much (unless your model is that the current draw cuts out when the voltage drops below some ULV threshold, but this threshold is still high enough to bias the SMPS enough to prevent proper startup, but that theory would need testing).

hartytp, 2019-09-07:
IMO a better solution here is documentation. e.g. having a high-level "treating your sinara cards with love" that includes basic things like not rapidly (<1s) power cycling them, powering then on when lying on metal (an apparent student favourite), etc

hartytp, 2019-09-07:
To put it another way, no power cycling should ever cause damage to a Sinara system. That would be a very serious bug IMO.

However, guaranteeing startup even with odd power cycling doesn't have good effort to reward ratio IMO. Even if we sort out all the LDOs there can be issues around ICs like DDSs, PLLs, etc locking up if not powered up correctly. That's really hard to fix if the boards start up with some capacitors charged.

hartytp, 2019-09-07:
Not to mention the fact that all rails should already have bleeds provided by the indicator leds (but if any of those are missing, that would warrant an issue)

gkasprow, 2019-09-07:
Recently my colleague broke programmable load by too fast power cycling. The fuse went off and we had to send it for reparation.

Closed 2019-09-07.

Thread 21 (2019-06-14):

Zotino v1.1 testing:

hartytp, 2019-06-14:
Things that I think are worth testing on Zotino v1.1:
- [x] Step response/rise time: switch from -10V to +10V and look at output on scope
- [ ] Noise spectrum with & without constant DAC updates. Look at +-FS and 0V
- [ ] Cross-talk (both before and after a 2m SCSI cable)
- [ ] Noise with TEC running
- [ ] Stability with + without TEC connected
- [ ] Small + large signal BW
- [ ] DC accuracy as a function of duty cycle (self-heating).

pathfinder49, 2020-07-07:
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

For the benefit of others rummaging for Zotino noise performance like me. The spurs look very similar to some I observed when testing Fastino. I would wager many of them have the same source (an AC ground loop involving the Kasli SMPS). I have  written a detailed breakdown of how to reduce/eliminate these spurs in Fastino [here](https://github.com/sinara-hw/Fastino/issues/56). I imagine some of the techniques found to work with Fastino would also work for Zotino.

Closed 2019-06-14.

Thread 22 (2019-06-14):

Zotino v1.1 errata

hartytp, 2019-06-14:
- [x] +12V supply to TEC IDC should have a separate ground return trace and not return the current through the main PCB ground. There should also be an electrolytic decoupling cap between +12V and gnd near the IDC.
- [x] Depending on what we decide to do with the Thermostat EEM, consider populating the IDC with a smaller one, which does not expose the I2C, +12V and +3V_mp
- [x] The GND trace between the thermistor and the TEC should be connected to Zotino's ground through a 0R resistor that is DNPd by default. The idea here is that we want to try to avoid creating a ground loop between Zotino and Thermostat if we can, so this should only be grounded at one end, not both. In general, it's best to ground this kind of thing at the Thermostat end rather than at the load end. Let's also add a note on the schematic saying that this pin should be grounded on the temperature controller end.
- [x] EEM LVDS signals should be zero-indexed
- [x] CS_EXT test point seems to be missing.

Closed 2019-06-14.

Thread 23 (2019-06-24):

Temperature IDC should be 10-pin

hartytp, 2019-06-24:
The I2C and power is not very useful. Design it to easily route to Thermostat via ribbon cable.

sbourdeauducq, 2021-03-07:
The 9-pin connectors do not have I2C, though I am not sure why it was there in the first place. @gkasprow any comment?

sbourdeauducq, 2021-03-07:
Seems we can just assemble a 9-pin IDC receptacle on Thermostat without changing the PCB design, the pinout is compatible.

sbourdeauducq, 2021-03-07:
@hartytp I assume you meant 10-pin

gkasprow, 2021-03-08:
we don't need I2c. I used a shorter connector, now it is compatible with Thermostat 10 pin one.
Pin 10 will be not used if you use IDC to DSUB9 cable

gkasprow, 2021-11-05:
fixed in 1.4

Closed 2021-11-05.

Thread 24 (2019-08-07):

Missing: IDC Connector Specs/Pitch

drewrisinger, 2019-08-07:
The IDC connector pitch & number of positions is not specified in either this project's Wiki/README's, nor [BNC-IDC](https://github.com/sinara-hw/BNC_IDC).

Visually it looks like it's a 2x13 @ 0.1" pitch polarized IDC connector, but I would prefer to have some confirmation before buying appropriate connectors.

**Request**: update the Wiki of both Zotino & BNC_IDC with appropriate connector information.

sbourdeauducq, 2019-08-08:
Those are very common connectors in electronics. If you want an easy way to obtain a Sinara system, you can purchase a pre-assembled crate including bitstreams, device database, etc.
Otherwise, writing this kind of basic documentation is a good first contribution.

drewrisinger, 2019-08-08:
@sbourdeauducq they are a common connector TYPE, but it's also simultaneously vague. Like specifying "FPGA" or "IC". What package do those refer to? `DIP != QFN != SOIC != TO`. https://en.wikipedia.org/wiki/Insulation-displacement_connector.

Based on @sbourdeauducq's very helpful response, and hunting down the BOM hidden under [releases](https://github.com/sinara-hw/Zotino/releases), I see that they are .1" x .1" 2x13 polarized IDC connectors (Socket = 3M_N2526-6002RB).

Wiki editing is limited to members of the `sinara-hw` Github group, so it's not a contribution that I can actually make.

gkasprow, 2019-08-09:
@drewrisinger if you want, I can give you access rights.

drewrisinger, 2019-09-03:
@gkasprow Sure, I can edit a few things. It looks like the UMD section of https://github.com/sinara-hw/meta/wiki/Team also needs to be updated because postdocs and staff have moved on (https://github.com/sinara-hw/Fastino/issues/2#issuecomment-526807081)

hartytp, 2019-09-03:
>  It looks like the UMD section of https://github.com/sinara-hw/meta/wiki/Team also needs to be updated because postdocs and staff have moved on (sinara-hw/Fastino#2 (comment))

I'd be more inclined to just scrap that section. Sinara usage has grown so fast that it's now very non-representative of the actual user base. It's also the kind of thing that tends to go out of date faster than it's updated so unlikely to be much help.

drewrisinger, 2019-09-03:
@hartytp @jbqubit I have no preference on the wiki/Team section, it's interesting and useful for people on-boarding to get an idea of the team members, but it does fall out of date.

Closed 2021-11-05.

Thread 26 (2019-11-23):

add TVS to EEM I2C

gkasprow, 2019-11-23:

gkasprow, 2021-11-05:
fixed in 1.4

Closed 2021-11-05.

Thread 27 (2019-12-18):

noise

jordens, 2019-12-18:
Scored a 89410a from the army for 500 €...

# Zotino v1.3 output voltage noise

* after 15 cm IDC cable, IDC-SMA, and 100 cm coax (~50 pF) , and 500 k || 150 pF
* 3.5 V DAC output
* on a running but otherwise idle Kasli
* in a shielded crate
* connected to RJ45 Ethernet
* class I power supply
* regular office environment
* after a few hours of thermalization
* c.f. previous https://github.com/sinara-hw/Zotino/issues/21#issuecomment-380472116
* c.f. CMC effects and crosstalk https://github.com/sinara-hw/Zotino/issues/21#issuecomment-376119235
* c.f. temperature coefficient https://github.com/sinara-hw/Zotino/issues/21#issuecomment-380401138
* look at trace A

tl;dr:

* stability is excellent to better than 10 µV peak over an hour, no discernible drift
* up to the filter bandwidth of 75 kHz about 200 nV/rtHz as expected
* at 4.6 nV/rtHz at 1 MHz. There is a bump up to 2 MHz that shouldn't be there from the model. My guess is that it's a joint effect of output driver, impedance (500 R || 2.2 nF), CMC-IDC-CMC, coax and analyzer impedance (500 k || 200 pF). That bump definitely exists. Might even be something intrinsic on Zotino. It would be nice to understand and model this. Also regarding Fastino and CMCs for these applications in general.
* above 4 MHz it's < 1nV/rtHz as expected, less then I care to measure now
* no unexpected spurs (the 0.9 Hz is a sideways mode of the table and the 89410a is pretty sensitive to vibrations, (2n+1) 50 Hz is expected and well behaved, 30 kHz is a CRT, stuff coming up towards 10 MHz is related to grounding).

## 0.69 mHz bandwidth, 5.0 µV/rtHz at 1.6 mHz
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

## 6.9 Hz bandwidth, 300 nV/rtHz at 300 Hz

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

## 6.9 kHz bandwidth, 210 nV/rtHz at 50 kHz, 4.6 nV/rtHz at 1 MHz, < 1 nV/rtHz at > 4 MHz

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

## old noise model

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

jordens, 2019-12-18:
Aaannd closing.

Closed 2019-12-18.

Thread 28 (2020-02-05):

connect SMPS shield to GND at the module input

gkasprow, 2020-02-05:

gkasprow, 2021-11-05:
fixed in v1.4

Closed 2021-11-05.

Thread 31 (2021-11-05):

v1.4 changelog

gkasprow, 2021-11-05:
- connected SMPS shield #28
- Added I2C TVS #26
- changed thermal controller IDC connector to 10pin one #23
- added support for CPCIS adapter #19
- fixed schematic label #29
- fixed R4 annotation #30

Closed 2023-09-19.

Thread 34 (2022-11-22):

HD68 Cables

andrewvh4, 2022-11-22:
I'm having a hard time finding suppliers for the HD68 cables needed. Most suppliers list them as `obsolete` or `out of stock`.

Does anyone know of a good supplier for these cables?

Also, if they are obsolete, is there any interest in changing the connector on the Zotino and related boards?

gkasprow, 2022-11-22:
I usually source them from eBay or [Ali](https://www.aliexpress.com/item/32807697575.html) or [Amazon](https://www.amazon.com/Ribbon-Cable-Adapter-Connector-16-40ft/dp/B0B9LF4QPC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)
You can also use [crimped plugs](https://my.rs-online.com/web/p/scsi-connectors/7390732) with original Zotino connectors
Yet another idea is to use SCSI to VHDCI adapter and VHDCI cables.

Zotino/Fastino can be fitted with the original HD68 or [3M MDR connectors ](https://www.3m.com/3M/en_US/p/d/b00037030/). They are pin-compatible but not plug-compatible.
MDR68 cables are easier to source. I.e. [here](https://www.tti.com/content/dam/ttiinc/manufacturers/3m/PDF/MDRSelectionGuide.pdf)
you can also make them using [IDC plugs](https://docs.rs-online.com/4164/0900766b8002f478.pdf) and ribbon cables

Closed 2023-09-19.

Thread 35 (2023-01-24):

L1 and J2 collision

pkozakiewicz, 2023-01-24:
Please see attached pictures, L1 should be moved away from IDC connector.

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

filipswit, 2023-02-01:
fixed in v1.4.2

Closed 2023-02-01.

Thread 37 (2023-03-29):

unreliable startup of alternate DC/DC

sbourdeauducq, 2023-03-29:
The startup current at the output of the alternate DC/DC (JHM0612D12) is excessive and can trip its short circuit protection. The DC/DC tries to restart but never manages to and the +/-12V rails remain unpowered.

The issue can be worked around by:
1. cutting the trace that connects SHDN# (pin 5) of IC27 to the input
2. soldering a 100K resistor above the cut
3. soldering a 1µF capacitor between SHDN# (pin 5) and GND (pin 6) of IC27

This delays the startup of the P12V0A rail and avoids overloading the DC/DC on power-up.

In my experiments, bootstrapping either the positive or the negative rail with a lab power supply allows the board to start. I have applied the workaround on the positive rail only because the soldering job was easier there.

I have not checked carefully if this is a good or the best solution. @gkasprow could you go over this?

maciejprzybysz, 2023-03-30:
We have tested our cards. We were able to reproduce the problem, but its occurrence is not deterministic. Only on few cards the inverter could not powerup. There was no problem with others. What's more, some cards that didn't work the day before were able to start up properly the next day.

The oscillograms of the P12V0 input voltage (yellow) and the positive output of the converter (green) look like this:
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

This new converter (JHM0612D12) has similar parameters as the previous one, but it is apparently worse at starting under load. There is ~65uF capacitance on each output of converter (max. capacitive load due to datasheet is 250uF).  But there are also two LDOs powered from the plus and minus of this converter that must charge one 10uF capacitor per DAC channel. So we have 32x10uF on N12V and 32x10uF on P12V. The negative LDO voltage has a nominal current capacity of 200mA, but the overcurrent protection according to the datasheet allows even 350mA or more temporarily. The positive LDO voltage has a nominal current efficiency of 500mA, and even more considering the current limit protection.

The converter has +/-250mA output current, but the documentation is quite poor when it comes to operation during powerup and current protection limits. After startup maximum Zotino current consumption should not exceed converter specification, but apparently there is problem during startup.

We made a similar fix on one piece, we used a 470nF capacitor and a 220k resistor. This delayed start of the second LDO by few ms (P12V LDO output - yellow, N12V LDO output - green):
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

Converter outputs after fix look like this:
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
Zoomed:
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

Output on the signal connector during start up:
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

It seems that at the moment this is the easiest way to fix, in next revision we can think about changing the LDO, e.g. with I_limit setting or simply implement this fix.

maciejprzybysz, 2023-04-05:
Due to the difficulty in reproducing the problem, I added a few capacitors on the P13V0 line. This allowed me to reproduce the problem every time the power was turned on.

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

At the beginning I turned off the P12V0 LDO to check if the converter can handle additional capacitance. This was not a problem. So I adjusted RC values to increase P12V0 LDO power up delay Now we have time constant above ~1s, but due to low threshold on LT1763 shutdown pin (0.8V typ) it delays power up only ~50ms.

Blue & red is +/-13V converter output, green is N12V0 LDO output, yellow is P12V0 LDO output.
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

Negative voltage LDO in SOT23-5 case has no shutdown pin, so we could only decrease capacitance on negative rail to improve startup reliability, but I think with increased P12V delay should be much better.

maciejprzybysz, 2023-09-19:
Fixed in v1.4.3 - voltage supervisors for P12V0 & N12V0 sequencing added

Closed 2023-09-19.

Thread 38 (2024-03-06):

TEC polarity on IDC connector opposite from Thermostat

QQ80, 2024-03-06:
The TEC polarity of the IDC connector for the temperature regulator is opposite from the one on the Thermostat.

Thermostat:
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

Zotino:
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

This is probably because Zotino's layout was based on the Thermostat's before its TEC polarity [label](https://github.com/sinara-hw/Thermostat/issues/90) [fix](https://github.com/sinara-hw/Thermostat/issues/97#issuecomment-830920487). The signals themselves on the Thermostat never changed, only the labels, but the connector on the Zotino based its polarity layout on the pre-switched labels, which is the source of the difference.

QQ80, 2024-03-06:
Here's the difference PCB view:

Thermostat:
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

Zotino:
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

Its not clear to me which should be switched, the Thermostat's or the Zotino's.

Thread 39 (2025-01-23):

Zotion-DIOT review

gkasprow, 2025-01-23:
@michalgaska

- [ ] missing exposed copper contact (top and bottom)
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
- [ ] missing sequencer reset
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
- [ ] missing DIOT and EEM assembly variants
- [ ] remove dead copper from polygons
- [ ] add polygon ground vias, now large fractions are floating
- [ ] 6 DRC errors

Thread 40 (2025-01-23):

Zotion-DIOT review

gkasprow, 2025-01-23:
@michalgaska

- [ ] missing exposed copper contact (top and bottom)
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
- [ ] missing sequencer reset
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
- [ ] missing DIOT and EEM assembly variants
- [ ] remove dead copper from polygons
- [ ] add polygon ground vias, now large fractions are floating
- [ ] 6 DRC errors

Closed 2025-01-23.

Thread 41 (2025-01-23):

Zotino-DIOT RFC

gkasprow, 2025-01-23:
Shall we add simplified temperature controlled to new revision?

gkasprow, 2025-01-23:
@sbourdeauducq showed some experiments with and without a Thermostat. Moreover, people sometimes ask us to install a Thermostat...
In the DIOT version, we could make a simple regulator based on a single opamp and PWM driver...
