sinara-hw/Zotino/(list of files, drawings)

Other design files:
PCB/DAC_32CH.SchDoc
PCB/Filter_simulations.SchDoc
PCB/LVDS_IFC_DAC.SchDoc
PCB/Output_channel.SchDoc
PCB/Supply_DAC.SchDoc
PCB/Zotino.PrjPCB
PCB/Zotino.schdoc
