sinara-hw/Zotino/(commit log)

2018-03-21 1.2rc1, fixed #492
    [DAC_32CH.SchDoc, Filter_simulations.SchDoc, LVDS_IFC_DAC.SchDoc, Output_channel.SchDoc, Supply_DAC.SchDoc, Zotino.PrjPCB, Zotino.schdoc]
2018-03-28 added panel design
    [Zotino.PrjPCB]
2018-07-10 added mod picture
    [Zotino.PrjPCB]
2019-09-03 Create README
    Clarify the location of schematics/BOMs/layouts, and point to wiki
2023-09-19 v1.4.3rc1 - Fixed issue #37 (power sequencing P12V/N12V) - Simulation pictures fixed - Added project version parameter - Version numbers updated
    [DAC_32CH.SchDoc, Filter_simulations.SchDoc, LVDS_IFC_DAC.SchDoc, Output_channel.SchDoc, Supply_DAC.SchDoc, Zotino.PrjPCB, Zotino.schdoc]
2023-09-19 v1.4.3rc2 - Sheet numbers updated - Import changes to PCB - Component links updated
    [DAC_32CH.SchDoc, Filter_simulations.SchDoc, LVDS_IFC_DAC.SchDoc, Output_channel.SchDoc, Supply_DAC.SchDoc, Zotino.schdoc]
